SebastiendOrnano/fours_pain/README.md

# fours_pain
Ce dépôt est dédié à la conception et la construction des fours à pain traditionnels en maçonnerie ou en en terre crue.
