SebastiendOrnano/fours_pain/(list of files, cad)

Other CAD files:
openscad_AVC-main/ellipse2.scad
openscad_AVC-main/ellipse3.scad
